scipilot/arduino-remote-control/README.md

# arduino-remote-control
My TV remote control broke, so I made a replacement.
