scipilot/arduino-remote-control/specs/IR-NEC-repeat-timing.png

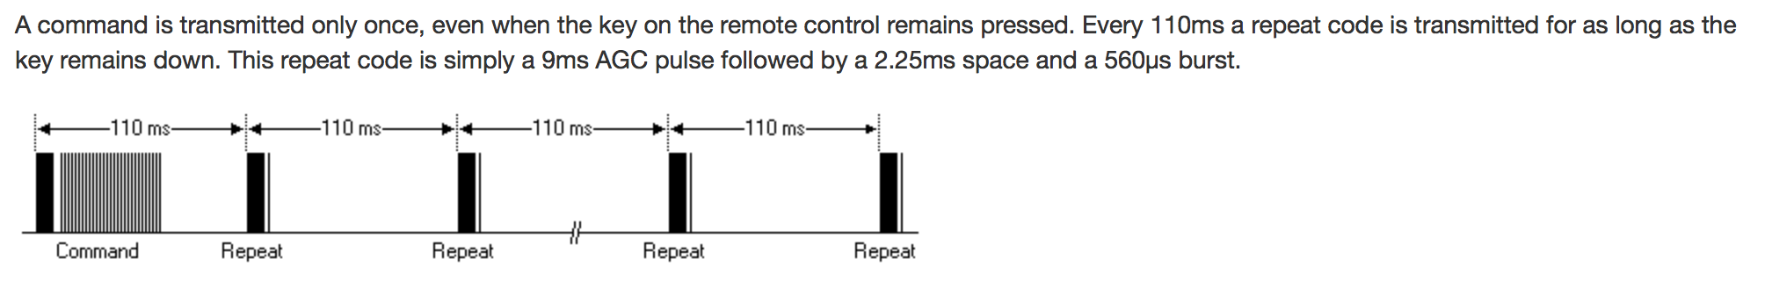
specs/IR-NEC-repeat-timing.png
