scipilot/arduino-remote-control/specs/Powerboost500-TPS-61090/adafruit_powerboost500C-Schematic.png

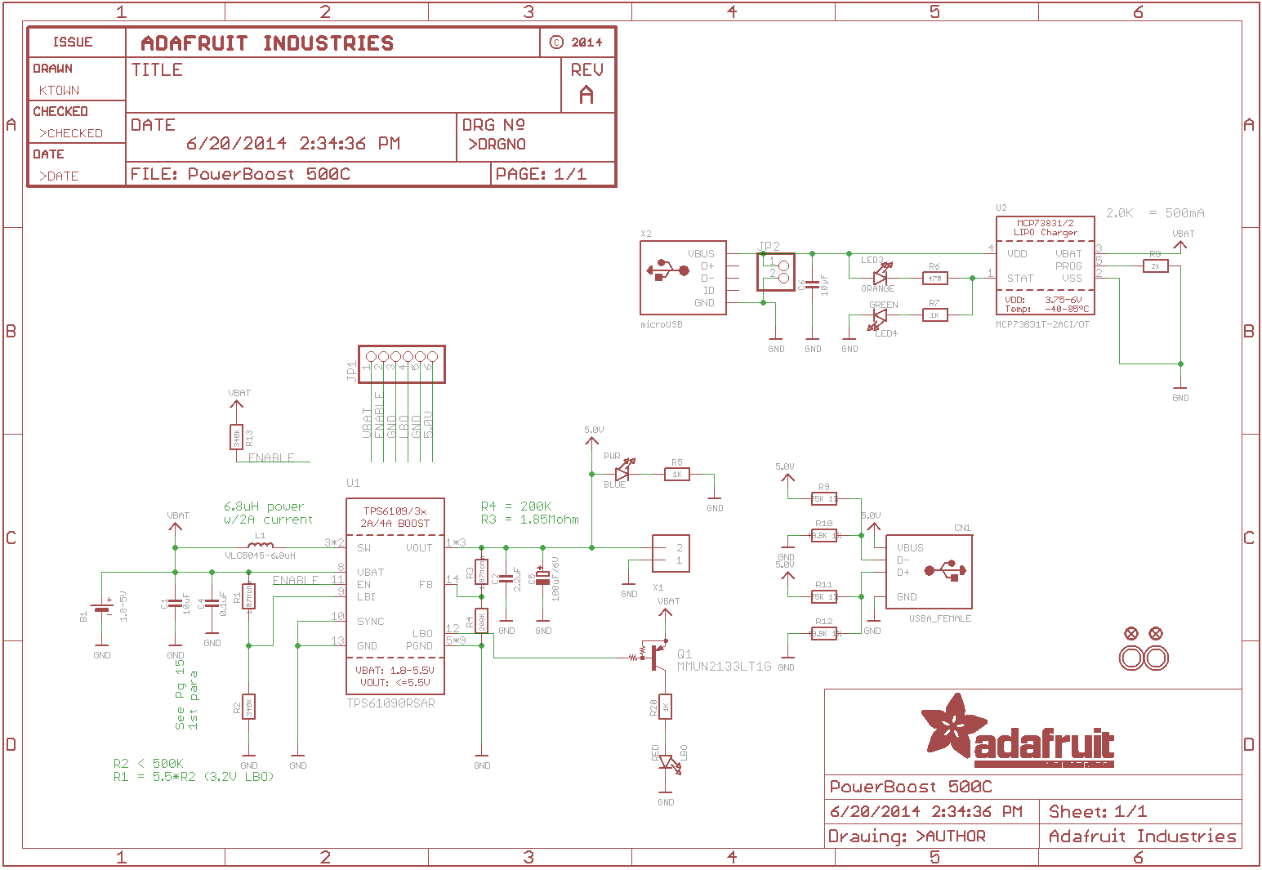
specs/Powerboost500-TPS-61090/adafruit_powerboost500C-Schematic.png
