scipilot/arduino-remote-control/specs/XC4512-PS-5DcDc/reverse/IMG_0754.JPG

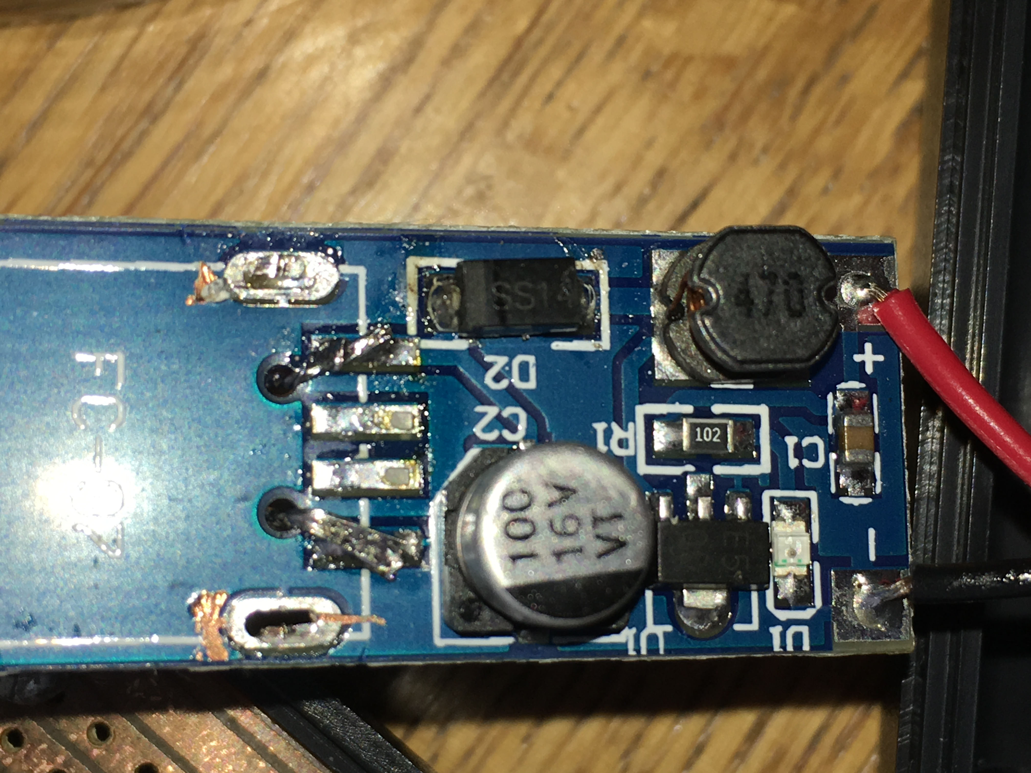
specs/XC4512-PS-5DcDc/reverse/IMG_0754.JPG
