scipilot/arduino-remote-control/specs/XC4512-PS-5DcDc/reverse/IMG_0757.JPG

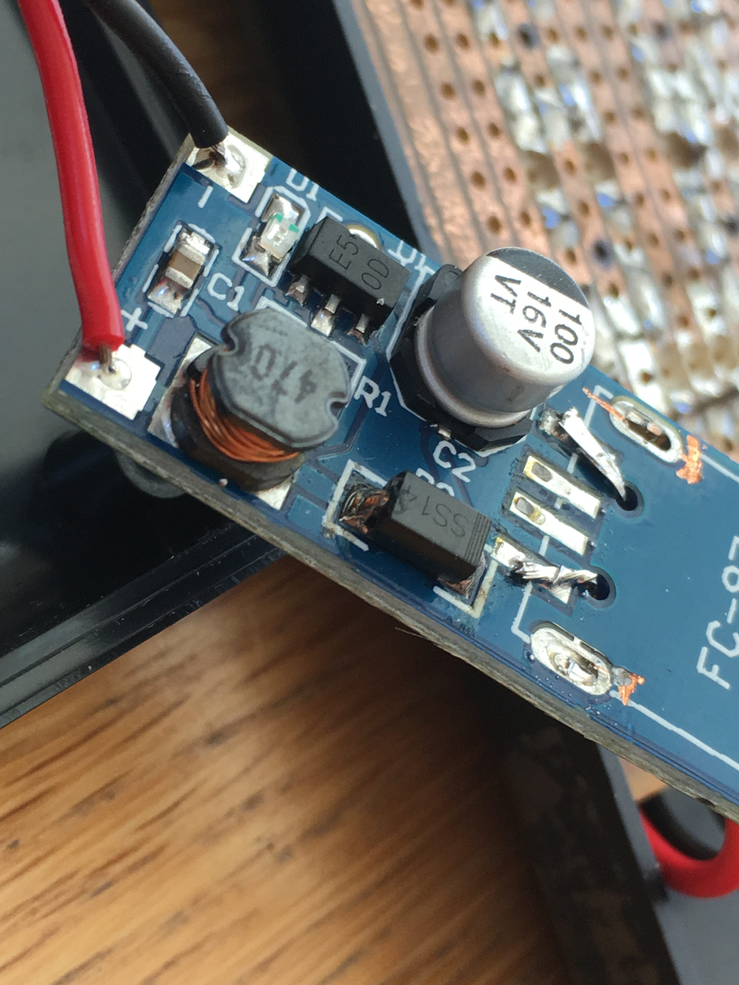
specs/XC4512-PS-5DcDc/reverse/IMG_0757.JPG
