scipilot/arduino-remote-control/specs/NCP1402_33V_step-up-v10/NCP1402_33V_step-up-v10.pdf

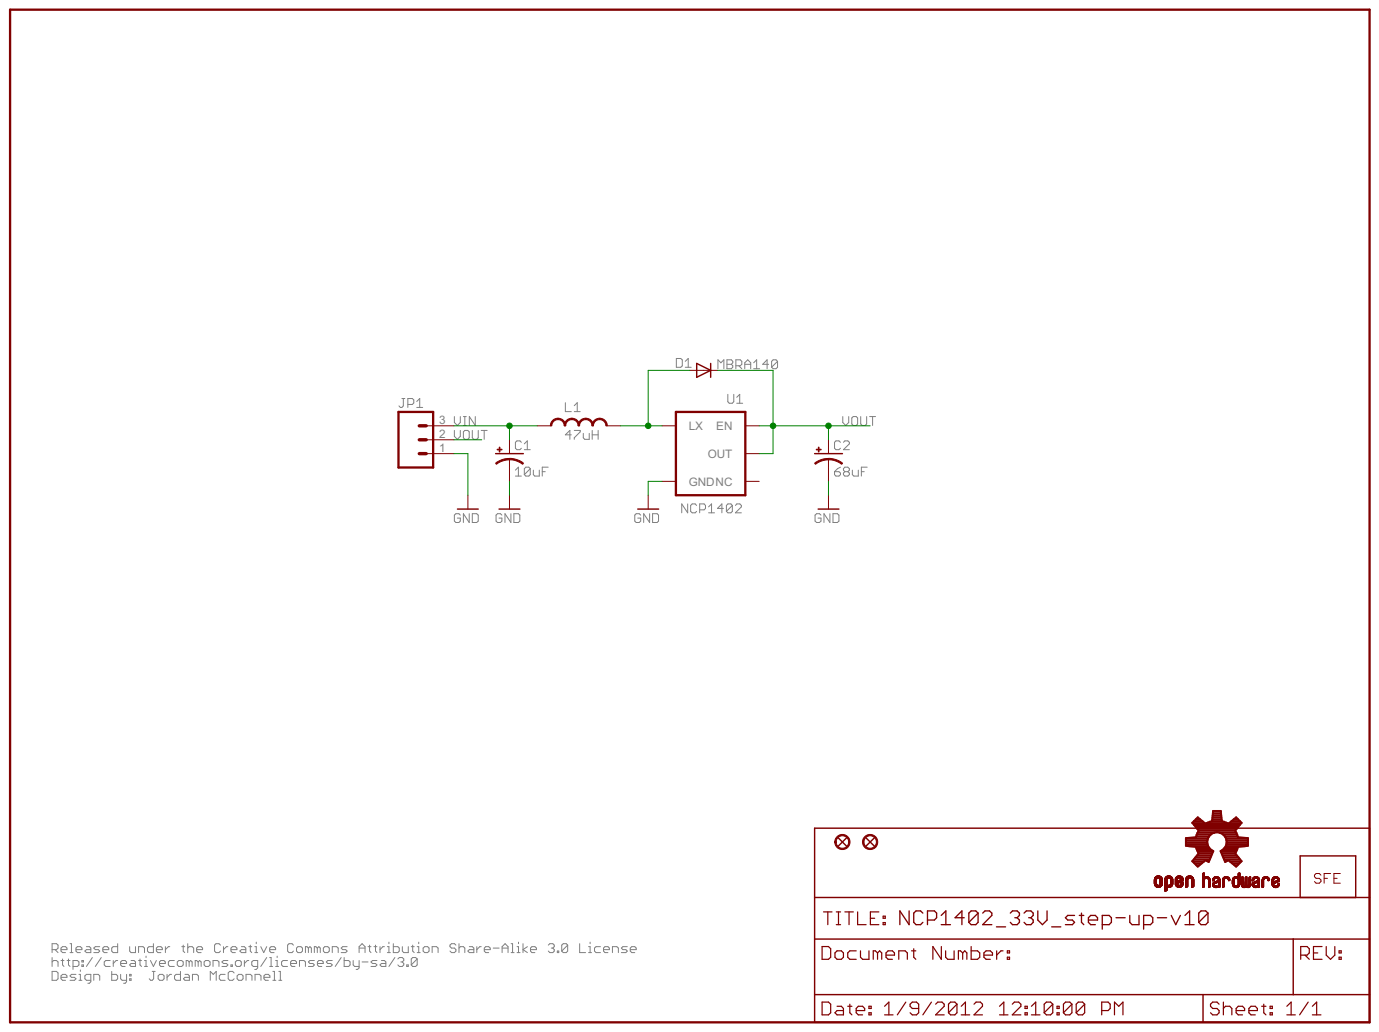
[picture p9: page 1]
