scipilot/arduino-remote-control/specs/Nano-reference/NanoV3.3.brd

## EAGLE design specs/Nano-reference/NanoV3.3.brd (2019-12-01)



Board: 2 copper layers, 43.2 x 17.8 mm, 33 parts (17 on the bottom side), 43 nets.

Parts:
C1, C4, C6, C9: 100nF; C0603-ROUND
C2, C5: 4,7uF_16V; TAN-A
C3, C7, C8: 1uF; C0603-ROUND
D1: SS1P3L; DO220AAL
D+: DNP; TP-1.00MM
D-: DNP; TP-1.00MM
F1: MFFSMF050; 0603-1608X90N
FRAME1: DNP; FRAME
IC1: FT232RL; SSOP28
IC2: LM1117IMPX-5.0; LINEAR_SOT223
IC3: 328P-MUR; VQFN32
J1, J2: XXXX_STRIPNANO; HEAD15-NOSS
J3: USB-MINI-B_2
J4: 2X03
L: Yellow; CHIPLED_0805
PWR: Green; CHIPLED_0805
RP1, RP2: 1K; CAY16
RX: Red; CHIPLED_0805
SW1: RESET; SMD_157SW
TX: Green; CHIPLED_0805
U$4, U$5, U$53, U$54: DNP; FD-1-1.5
Y1: 16MHz; RESONATOR

Connections:
3V3: C6.2, IC1.17, J2.14
+5V: C3.1, C5.1, C7.1, C8.1, D1.P$1, IC1.4, IC1.20, IC2.2, IC2.4, IC3.4, IC3.6, IC3.18, J2.4, J4.2, RP1.5, RP1.6, RX.A, TX.A
A0: IC3.23, J2.12
A1: IC3.24, J2.11
A2: IC3.25, J2.10
A3: IC3.26, J2.9
A4: IC3.27, J2.8
A5: IC3.28, J2.7
A6: IC3.19, J2.6
A7: IC3.22, J2.5
AREF: C1.1, IC3.20, J2.13
COM: C1.2, C2.2, C3.2, C5.2, C6.1, C7.2, C8.2, C9.2, IC1.7, IC1.18, IC1.21, IC1.25, IC1.26, IC2.1, IC3.3, IC3.5, IC3.21, IC3.33, J1.4, J2.2, J3.1, J3.6, J3.7, J3.8, J3.9, J4.6, L.C, PWR.C, RP2.3, RP2.6, SW1.1, Y1.2
D0/RX: IC3.30, J1.2, RP1.1
D1/TX: IC3.31, J1.1, RP1.2
D2: IC3.32, J1.5
D3: IC3.1, J1.6
D4: IC3.2, J1.7
D5: IC3.9, J1.8
D6: IC3.10, J1.9
D7: IC3.11, J1.10
D8: IC3.12, J1.11
D9: IC3.13, J1.12
D10: IC3.14, J1.13
D11/MOSI: IC3.15, J1.14, J4.4
D12/MISO: IC3.16, J1.15, J4.1
D13/SCK: IC3.17, J2.15, J4.3, RP2.1
unnamed: IC3.8, Y1.3
unnamed: IC3.7, Y1.1
unnamed: PWR.A, RP1.3
unnamed: C4.2, IC1.2
unnamed: D+.X, IC1.15, J3.3
unnamed: D-.X, IC1.16, J3.4
unnamed: L.A, RP2.8
unnamed: IC1.23, RP2.2
unnamed: IC1.22, RP2.4
unnamed: RP2.5, TX.C
unnamed: F1.2, J3.5
unnamed: RP2.7, RX.C
RESET: C4.1, IC3.29, J1.3, J2.3, J4.5, RP1.4, SW1.2
RX: IC1.1, RP1.8
TX: IC1.5, RP1.7
VIN: IC2.3, J2.1
VUSB: C2.1, C9.1, D1.P$2, F1.1
