scipilot/arduino-remote-control/sketches/IRrecvDump/IRrecvDump.ino

/*
 * IRremote: IRrecvDump - dump details of IR codes with IRrecv
 * An IR detector/demodulator must be connected to the input RECV_PIN.
 * Version 0.1 July, 2009
 * Copyright 2009 Ken Shirriff
 * http://arcfn.com
 * JVC and Panasonic protocol added by Kristian Lauszus (Thanks to zenwheel and other people at the original blog post)
 * LG added by Darryl Smith (based on the JVC protocol)
 */

#include <IRremote.h>
#include "gva.h"

/* 
*  Default is Arduino pin D11. 
*  You can change this to another available Arduino Pin.
*  Your IR receiver should be connected to the pin defined here
*/
int RECV_PIN = 11;

IRrecv irrecv(RECV_PIN);

decode_results results;

void setup()
{
  Serial.begin(9600);
  Serial.println("IRRecvDump starting...");
  irrecv.enableIRIn(); // Start the receiver
}


void dump(decode_results *results) {
  // Dumps out the decode_results structure.
  // Call this after IRrecv::decode()
  int count = results->rawlen;
  if (results->decode_type == UNKNOWN) {
    Serial.print("Unknown encoding: ");
  }
  else if (results->decode_type == NEC) {
    Serial.print("Decoded NEC: ");
  }
  else if (results->decode_type == SONY) {
    Serial.print("Decoded SONY: ");
  }
  else if (results->decode_type == RC5) {
    Serial.print("Decoded RC5: ");
  }
  else if (results->decode_type == RC6) {
    Serial.print("Decoded RC6: ");
  }
  else if (results->decode_type == PANASONIC) {
    Serial.print("Decoded PANASONIC - Address: ");
    Serial.print(results->address, HEX);
    Serial.print(" Value: ");
  }
  else if (results->decode_type == LG) {
    Serial.print("Decoded LG: ");
  }
  else if (results->decode_type == JVC) {
    Serial.print("Decoded JVC: ");
  }
  else if (results->decode_type == AIWA_RC_T501) {
    Serial.print("Decoded AIWA RC T501: ");
  }
  else if (results->decode_type == WHYNTER) {
    Serial.print("Decoded Whynter: ");
  }
  Serial.print(results->value, HEX);
  Serial.print(" (");
  Serial.print(results->bits, DEC);
  Serial.println(" bits)");
  // raw
  Serial.print("Raw (");
  Serial.print(count, DEC);
  Serial.print("): ");
/*
  for (int i = 1; i < count; i++) {
    if (i & 1) {
      Serial.print(results->rawbuf[i]*USECPERTICK, DEC);
    }
    else {
      Serial.write('-');
      Serial.print((unsigned long) results->rawbuf[i]*USECPERTICK, DEC);
    }
    Serial.print(" ");
  }*/
  Serial.println();

  // PJ: I added my key decoding here too
  if (results->decode_type == NEC) {
    int key = mapCommandToKey(results->value);
    Serial.print("Detected KEY: ");
    Serial.println(key);
  }
  Serial.println("--");
}

// Map2: first paper cover trial
long keyMap2[16] = {
  GVA_32TDC15_P_MODE,   // 1
  GVA_32TDC15_S_MODE,   // 2
  GVA_32TDC15_SOURCE,   // 3
  GVA_32TDC15_MUTE,     // 4
  GVA_32TDC15_MENU,     // 5
  GVA_32TDC15_UP,       // 6
  GVA_32TDC15_EJECT,    // 7
  GVA_32TDC15_VOL_UP,   // 8
  GVA_32TDC15_LEFT,     // 9
  GVA_32TDC15_ENTER,    // 10 alt-play after alt-pause
  GVA_32TDC15_RIGHT,    // 11
  GVA_32TDC15_VOL_DN,   // 12
  GVA_32TDC15_EXIT,     // 13
  GVA_32TDC15_DOWN,     // 14
  GVA_32TDC15_PLAY_PAUSE, // 15   // GVA_32TDC15_GRN_STEP, // 10 alt-pause
  GVA_32TDC15_D_MENU,   // 16
};
long mapKeyToCommand(int key) {
  long command;

  command = keyMap2[key - 1];

  return command;
}

// Finds the 1-16 key from the HEX IR command
int mapCommandToKey(long command){
    for (int i = 1; i < 17; i++) {
      if(keyMap2[i] == command){
        return i+1;
      }
    }
    return -1;
}

void loop() {
  if (irrecv.decode(&results)) {
    Serial.println(results.value, HEX);
    dump(&results);
    irrecv.resume(); // Receive the next value
  }
}
