scipilot/arduino-remote-control/sketches/IRrecvDump/panasonic_dvd_ir6.h

// NEC MAP for Panasonic Remote DVD IR6
#define PAN_IR6_POWER						0x406A954D			
#define PAN_IR6_POWER_TV					0xE0E040BF			
#define PAN_IR6_UP							0xE246AFCA		
#define PAN_IR6_RIGHT						0xBB0EDD22			
#define PAN_IR6_LEFT						0x4D43596A			
#define PAN_IR6_DOWN						0x3AFB26D4
#define PAN_IR6_ENTER						0xB520CEC     // OK			
#define PAN_IR6_EXIT						0x6EB8C67
#define PAN_IR6_SOURCE						0xD2472D7D    // input select
#define PAN_IR6_DRIVE_SELECT				0xC2D004A3    // drive select
#define PAN_IR6_DTVATV						0xE0E0807F    // AV
#define PAN_IR6_DISPLAY						0x720D8C26
#define PAN_IR6_VOL_UP						0xE0E0E01F		    // TV	
#define PAN_IR6_VOL_DN						0xE0E0D02F            // TV
#define PAN_IR6_CHAN_UP						0x68E69B7F            // TV
#define PAN_IR6_CHAN_DN						0x223C02A7
#define PAN_IR6_CHAN_UP_TV					0x68E69B7F            // TV
#define PAN_IR6_CHAN_DN_TV					0xE0E008F7
#define PAN_IR6_PAUSE	    				0xAA7B2167
#define PAN_IR6_PLAY		    			0xDEC919A5
#define PAN_IR6_STOP						0x1D15F4D7
#define PAN_IR6_FAST_BACK					0xA23B903F
#define PAN_IR6_FAST_FORW					0x59135E7			
#define PAN_IR6_SKIP_BACK					0x1F6E01C9					 
#define PAN_IR6_SKIP_FORWARD				0x2E8C2A89
#define PAN_IR6_AUDIO      					0xB893D8E7
#define PAN_IR6_SUBTITLE  					0xFA261861
#define PAN_IR6_RED  		    			0x21E03521				
#define PAN_IR6_GRN		    	    		0x37E9AB17				
#define PAN_IR6_YEL	    			    	0xA8E5B717					
#define PAN_IR6_BLU 						0x1C5A3161				
#define PAN_IR6_NUM_1						0x51731C91		
#define PAN_IR6_NUM_2						0x4A1144F9		
#define PAN_IR6_NUM_3						0x226873C1		
#define PAN_IR6_NUM_4						0x10957521		
#define PAN_IR6_NUM_5						0xC0E837B9		
#define PAN_IR6_NUM_6						0x52118DA9		
#define PAN_IR6_NUM_7						0x52118DA9		 
#define PAN_IR6_NUM_8						0x403E8F09		
#define PAN_IR6_NUM_9						0x303A9883		
#define PAN_IR6_NUM_0						0x38A296A3		
#define PAN_IR6_PROG_CHECK					0x24E4BE49
#define PAN_IR6_STATUS  					0x74666B4D    // i
#define PAN_IR6_RETURN  					0x57160F5A
#define PAN_IR6_DEL  				    	0xDB6AB119
#define PAN_IR6_GUIDE  				    	0xBE66B93D
#define PAN_IR6_NAVIGATOR  				    0xDBDC40AE
#define PAN_IR6_FUNCTION_MENU  				0xBB0EDD22
#define PAN_IR6_OPTION                      0xD5B03D84
#define PAN_IR6_CAST                        0xF17CD7C5
#define PAN_IR6_TIME_SLIP                   0xE5F231F1
#define PAN_IR6_MAN_SLIP_10S                0xA05FCF46
#define PAN_IR6_MAN_SLIP_60S                0x267DC449
