scipilot/arduino-remote-control/sketches/IRrecvDump/gva.h

// NEC MAP for GVA Remote 32TDC15
#define GVA_32TDC15_POWER						0xFEA857			
#define GVA_32TDC15_MUTE						0xFE6897			
#define GVA_32TDC15_UP							0xFE30CF		
#define GVA_32TDC15_RIGHT						0xFE708F			
#define GVA_32TDC15_LEFT						0xFEF00F			
#define GVA_32TDC15_DOWN						0xFEB04F
#define GVA_32TDC15_ENTER						0xFE08F7			
#define GVA_32TDC15_EXIT						0xFEC837
#define GVA_32TDC15_SOURCE						0xFE48B7
#define GVA_32TDC15_DTVATV						0xFED02F
#define GVA_32TDC15_DISPLAY						0xFE28D7
#define GVA_32TDC15_MTS 						0xFEE817
#define GVA_32TDC15_LOOP						0xFE50AF			
#define GVA_32TDC15_MENU						0xFE8877			
#define GVA_32TDC15_P_MODE						0xFEB847			
#define GVA_32TDC15_S_MODE						0xFE7887			
#define GVA_32TDC15_SLEEP						0xFE38C7
#define GVA_32TDC15_VOL_UP						0xFED827			
#define GVA_32TDC15_VOL_DN						0xFE58A7
#define GVA_32TDC15_CHAN_UP						0xFE9867
#define GVA_32TDC15_CHAN_DN						0xFE18E7
#define GVA_32TDC15_EJECT						0xFEC23D			
#define GVA_32TDC15_PLAY_PAUSE					0xFE42BD
#define GVA_32TDC15_STOP						0xFE827D
#define GVA_32TDC15_FAST_BACK					0xFEE21D
#define GVA_32TDC15_FAST_FORW					0xFE629D			
#define GVA_32TDC15_SKIP_BACK					0xFEA25D					 
#define GVA_32TDC15_SKIP_FORWARD				0xFE22DD
#define GVA_32TDC15_D_MENU						0xFEF20D			
#define GVA_32TDC15_D_TITLE						0xFE728D			
#define GVA_32TDC15_D_SETUP_OSD					0xFE02FD					
#define GVA_32TDC15_D_GOTO  					0XFEB24D					
#define GVA_32TDC15_D_DISP  					0XFE32CD
#define GVA_32TDC15_ZOOM      					0xFED22D
#define GVA_32TDC15_ANGLE      					0xFE52AD
#define GVA_32TDC15_AUDIO      					0xFE926D
#define GVA_32TDC15_SUBTITLE  					0XFE12ED
#define GVA_32TDC15_RED_PROG					0xFECA35				
#define GVA_32TDC15_GRN_STEP					0xFE4AB5				
#define GVA_32TDC15_YEL_REPEAT					0xFE8A75					
#define GVA_32TDC15_BLU_AB						0xFE0AF5				
#define GVA_32TDC15_NUM_1						0xFE807F		
#define GVA_32TDC15_NUM_2						0xFE40BF		
#define GVA_32TDC15_NUM_3						0xFEC03F		
#define GVA_32TDC15_NUM_4						0xFE20DF		
#define GVA_32TDC15_NUM_5						0xFEA05F		
#define GVA_32TDC15_NUM_6						0xFE609F		
#define GVA_32TDC15_NUM_7						0xFEE01F		 
#define GVA_32TDC15_NUM_8						0xFE10EF		
#define GVA_32TDC15_NUM_9						0xFE906F		
#define GVA_32TDC15_NUM_0						0xFE00FF		
