scipilot/arduino-remote-control/sketches/IRrecvDemo/IRrecvDemo.ino

/* IRremote: IRrecvDemo - demonstrates receiving IR codes with IRrecv * An IR detector/demodulator must be connected to the input RECV_PIN. * Version 0.1 July, 2009
  Copyright 2009 Ken Shirriff
  http://arcfn.com
*/
//code added to decode buttons from Duinotech remote
// only slightly modified from Library example
#include <IRremote.h>

int RECV_PIN = 11;
IRrecv irrecv(RECV_PIN);
decode_results results;

// remember last time, to provide log offsets for timing
long getDelta(){
  static unsigned long m;
  unsigned long now = millis();
  long delta = now - m;
  m = now;

  return delta;
}

// Logs with time since last message for timing (replaces Serial.println)
void log(char *msg){
  Serial.print(getDelta());
  Serial.print(": ");
  Serial.println(msg);
}
void log(unsigned long msg, int format){
  Serial.print(getDelta());
  Serial.print(": ");
  Serial.println(msg, format);
}

void setup()
{
  Serial.begin(9600);
  irrecv.enableIRIn(); // Start the receiver
  Serial.println("Setup. Waiting..."); 
}


void loop() {
if(irrecv.decode(&results)){

    log(results.value, HEX);

    /*
    switch (results.value) {
      case 0xFF629D:
        Serial.println("UP"); break;
      case 0xFF22DD:
        Serial.println("LEFT"); break;
      case 0xFF02FD:
        Serial.println("OK"); break;
      case 0xFFC23D:
        Serial.println("RIGHT"); break;
      case 0xFFA857:
        Serial.println("DOWN"); break;
      case 0xFF6897:
        Serial.println("1"); break;
      case 0xFF9867:
        Serial.println("2"); break;
      case 0xFFB04F:
        Serial.println("3"); break;
      case 0xFF30CF:
        Serial.println("4"); break;
      case 0xFF18E7:
        Serial.println("5"); break;
      case 0xFF7A85:
        Serial.println("6"); break;
      case 0xFF10EF:
        Serial.println("7"); break;
      case 0xFF38C7:
        Serial.println("8"); break;
      case 0xFF5AA5:
        Serial.println("9"); break;
      case 0xFF42BD:
        Serial.println("*"); break;
      case 0xFF4AB5:
        Serial.println("0");
        break;
      case 0xFF52AD:
        Serial.println("#"); break;
    }
    */
    irrecv.resume(); // Receive the next value
  }
  delay(100);
}
