scipilot/arduino-remote-control/(commit log)

2019-12-01 Initial import of working demo
    [NanoV3.3.brd, NanoV3.3.sch]
2019-12-02 Scanned codes from broken buttons with metal.
    [gva.h]
2019-12-02 Working draft of Low Power sleep + interrupt wake from keypad. Needs tuning, but this works and sends the IR command.
2019-12-03 Many experiments to debug the REPEAT key not working. In the end I found the IRRemote library IRsend::sendNEC() was actually wrong. I modified the header space and fixed an undefined behaviour bug.
    It's the (non sleepy) TransmitFromKeypad which is working.
    Everything else can be reverted/tidied up!
    Added timing log functions (duplicated).
    [IRTransmitFromKeypad.ino, IRTransmitKeypadSleep.ino, IRrecvDemo.ino, IRrecvDump.ino]
2019-12-04 More info on the repeat fix
    [IRTransmitFromKeypad.ino]
2019-12-27 Powerboost specs
2019-12-27 Added KEY map to receive debugger
    (with annoying duplicate of header!)
    see https://arduino.stackexchange.com/questions/348/how-to-organize-my-arduino-projects-structure-for-easy-source-control
2020-01-25 Flash LED while sending (like TX when unplugged) for user-feedback.
    Mappings for Mac+Helen's Panasonic TV/DVD
    RecvDump: Fix wrong key detection
    Debugging/notes/todo's
    [IRTransmitFromKeypad.ino, IRTransmitKeypadSleep.ino, IRrecvDump.ino, panasonic_dvd_ir6.h, samsung_dvd_AA59-00602A.h]
2020-02-09 Initial draft of micro-switch keypad matrix reader version, requiring iteration.
2020-02-09 Fix inverted output pins, and maths errors.
    [IRTransmitFromSwitchMatrix.ino]
2020-02-09 Fix error in key map
    [IRTransmitFromSwitchMatrix.ino]
2020-02-16 Microswitch row/col keymap - working in plastic case.
2020-02-16 Different boost power regulator, from 2AAs or Li to 5V.
2020-04-26 Fixed the REPEAT signal in the microswitch version. - Was broken by loop timing delays (was at 266ms should 110ms) - Note this still relies on the patch in the ir_NEC.cpp which isn't in the official 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
    [IRTransmitFromSwitchMatrix.ino]
2020-06-08 Power consumption reduction experiments - used RocketScream/LowPower to sleep for 60ms intervals to reduce to 50mA from 72mA. This broke the REPEAT timing of course (went to 280ms from 126ms) so: - r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
    Noted REPEAT still worked at 164ms loop (supposed to be 110ms)
    Tried going up to 120ms sleep, but REPEAT didn't work (at 198ms loop)
    and nothing left to optimise back down? Will have to do something like
    only sleep when not REPEATING?
    [IRTransmitFromSwitchMatrix.ino]
2020-10-18 Working draft of IDLE sleep power saving mode.
    Requires interrupt Pin 2 to be strapped to the 4 inputs. (Tested with one.)
    In sleep, the matrix outputs are all set low, and strobing stops.
    The interrupt pin floats high, via the other inputs' internal pullups (it doesn't need another).
    When any switch is pressed during sleep, the interrupt pin is pulled low
    via the matrix outputs, triggering the wakeup process.
    Then the key can be read normally (hopefully quickly enough).
    [IRTransmitFromSwitchMatrix.ino]
2021-02-04 5x4 version of microswitch-controlled IR with a 5 outs x 4 ins matrix keypad forked from "TransmitFromSwitchMatrix.ino"
    - working, with debug output
    - keymap not finished
    - uses sleep and interrupt pin to wake (instead of sleep-cycle)
    - has some extra power saving experiments requiring tools.h and cpu.h
    (currently commented out as they didn't seem to increase power saving)
    [IRTransmitFromSwitchMatrix5x4.ino]
2021-02-06 Various power saving experiments, all disabled.
    Moved the pin setup to a function, to be able to optimise the power usage of the pins during sleep.
    After benchmarking, this does have a small effect, but seems hardware dependent,
    as I got different results from other people.
2021-02-10 Working version of sleep+interrupt wake direct to Atmega328P, took ages. I think the: for (byte i = 0; i <= A5; i++) is wrong? The outputs are not pulled low. Needs tidying up!
    [IRTransmitFromSwitchMatrix5x4.ino]
2021-06-06 Debug: refactor all Serial.Print to a macro. BUT cannot remove it yet, at it breaks the IR timing!
